RobotStudyCompanion/MechDesign/RSC_v4_1.step

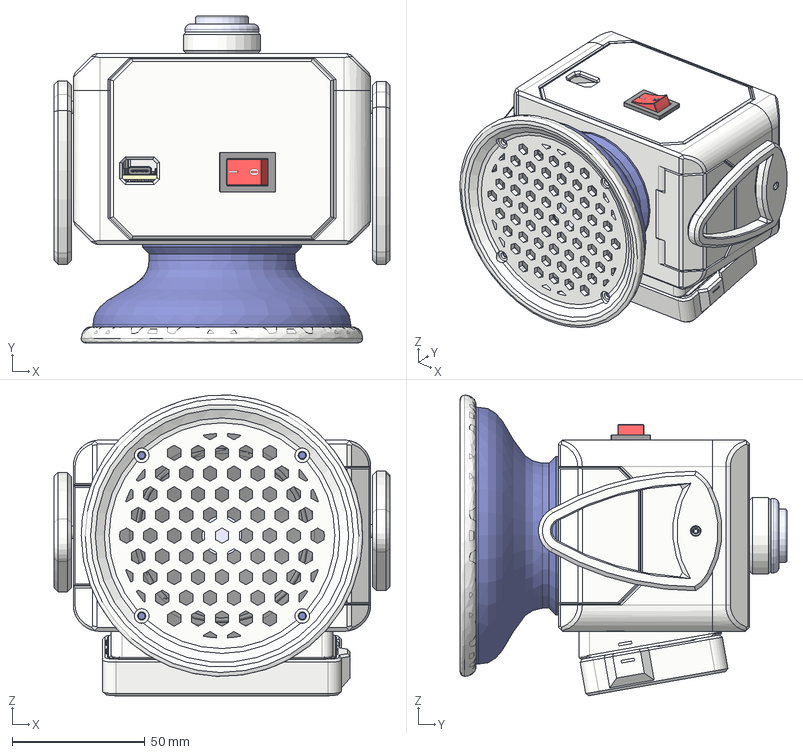
[picture p1: CAD file, 2026-01-30]
RSC_v4_1.step
126.5 x 123.0 x 113.2 mm
Sealing_Ring
Speaker_Trim
base_speaker
base2_speaker
PCB, RPi4ModelB
Broadcom BCM2711B0 CPU, RPi4ModelB
2.54 mm DUPONT MALE PIN HEADER, POE, 2X2, RPi4ModelB
2.54 mm DUPONT MALE PIN HEADER, IO, 2X20, RPi4ModelB
Camera Connector, RPi4ModelB
Microphone Plug, RPi4ModelB
Display Connector, RPi4ModelB
Gigabit Ethernet Port, RPi4ModelB
Female Micro HDMI Connector, RPi4ModelB x 2
Female USB Type C Connector, RPi4ModelB
2X USB3.0 PORTS, RPi4ModelB
91D77 D9WHV 778K, 4 GB LPDDR4 SDRAM, RPi4ModelB
Cypress CYW43455 Wireless Module Cover, RPi4ModelB
SD Card Slot, RPi4ModelB
VIA VL805 PCIe USB 3.0 controller, RPi4ModelB
2X USB2.0 PORTS, RPi4ModelB
Broadcom BCM54213PE Gigabit Ethernet Transceiver, RPi4ModelB
MxL7704 Universal PMIC, RPi4ModelB
VoiceBonnet
TactalSwitch-SMD
earphone
Motor base x 2
shaft x 2
top x 2
servo_shaft x 2
servo_horn x 2
SD_Latch
USB_Latch
flipper x 2
Arcade_PushButton
NeoPixelRing16
ButtonLock_Nut
Lambalı Anahtar - Gövde
Lambalı Anahtar - Tuş
Lambalı Anahtar - Tuş arkası
Panel_Adapter
10mm connector x 3
Spkr Connector
switch_1 x 2
Micro SD Card
ESP32 WROOM
Micro USB 5 Pins, Right Angle SMT v1
LDR 21
