RobotStudyCompanion/MechDesign/v4_1/print_project_a1m_RSC_v4_1_v256.3mf

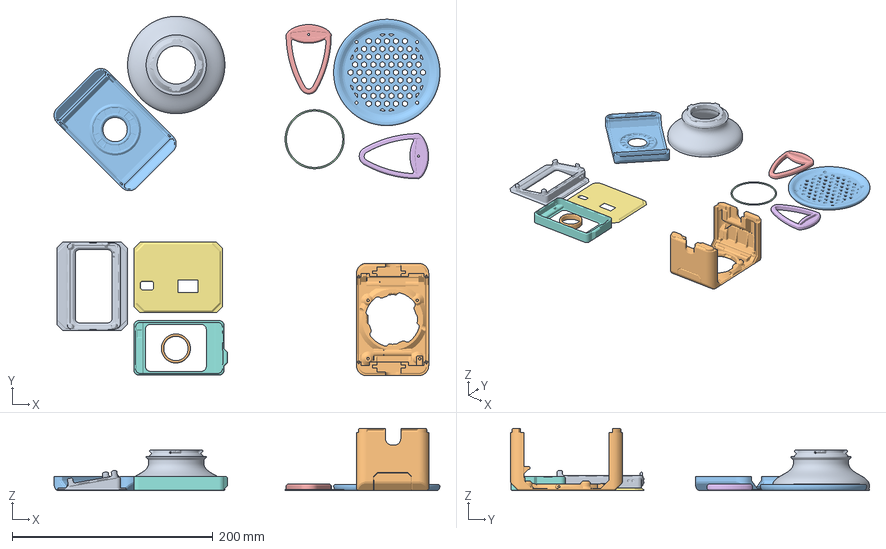
[picture p2: CAD file, 2026-01-30]
v4_1/print_project_a1m_RSC_v4_1_v256.3mf
384.7 x 358.1 x 62.0 mm
Speaker_Shroud
chassis_RSC_v4_1_v256
Base_Trim
Seal
flipper x 2
Back_Panel
LCD_Cover
Panel_Adapter
Spacer
Lid
