RobotStudyCompanion/MechDesign/v4_1/v4_1_2/TPU_flipper_RSC_v4_1_v282.3mf

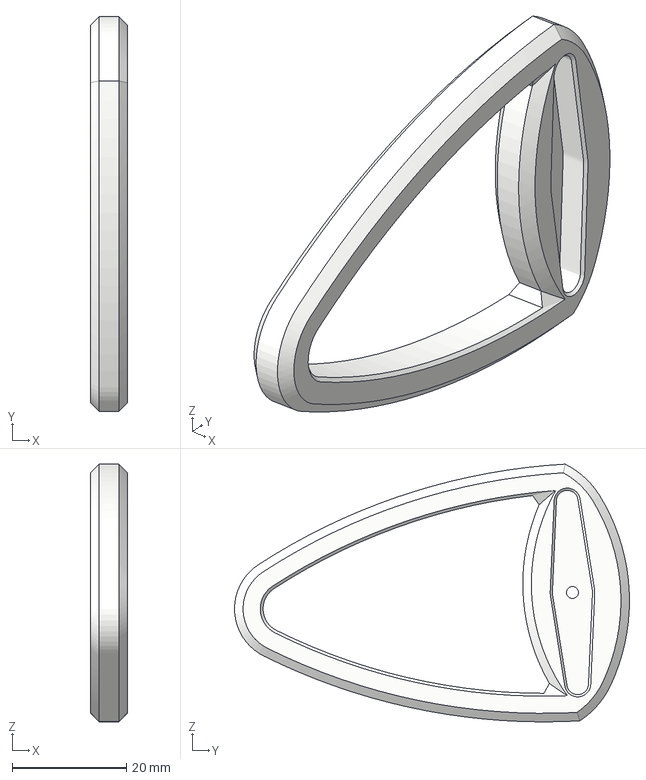
[picture p3: CAD file, 2026-08-03]
v4_1/v4_1_2/TPU_flipper_RSC_v4_1_v282.3mf
6.50 x 69.1 x 45.1 mm
