RobotStudyCompanion/MechDesign/RSCv4_base_lid_flipper.3mf

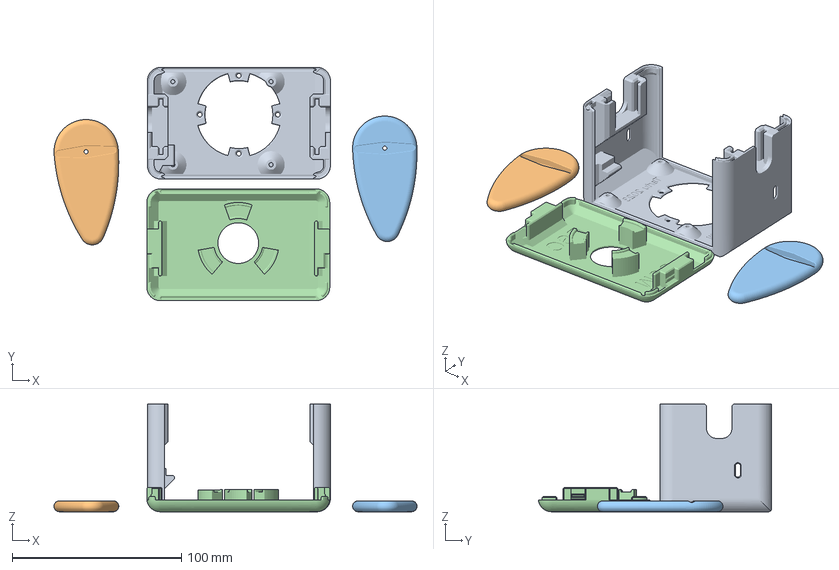
[picture p4: CAD file, 2023-09-24]
RSCv4_base_lid_flipper.3mf
214.2 x 137.8 x 63.5 mm
body_bracket
flipper x 2
lid_panel
