RobotStudyCompanion/MechDesign/v4_1/front_panel_RSC_v4_1_v267.3mf

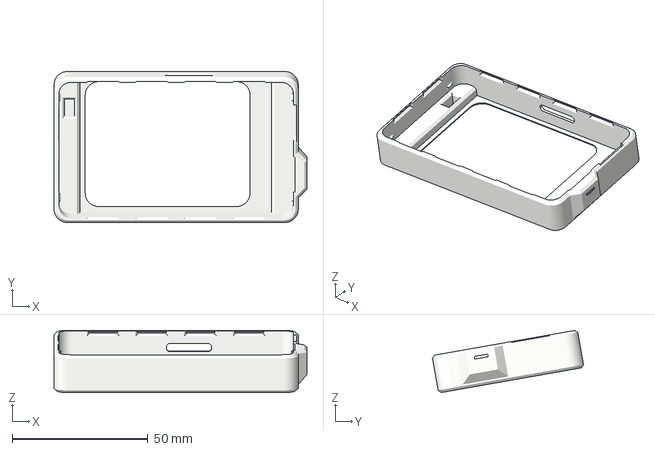
[picture p5: CAD file, 2026-01-30]
v4_1/front_panel_RSC_v4_1_v267.3mf
93.2 x 55.7 x 22.9 mm
