RobotStudyCompanion/MechDesign/RSCv4_speaker_shroud.3mf

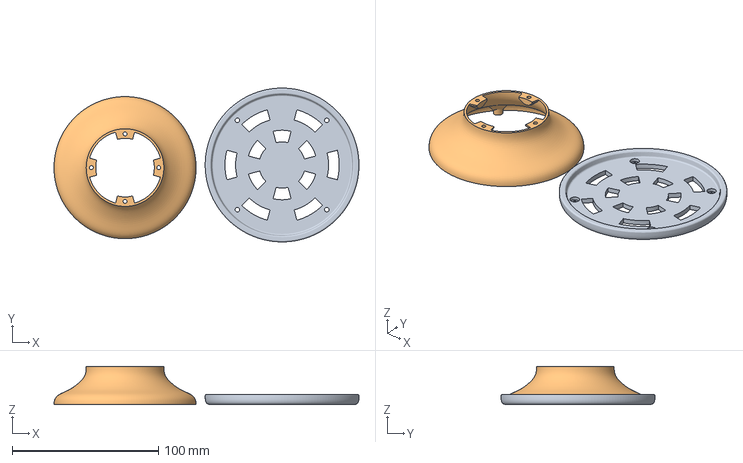
[picture p7: CAD file, 2023-09-24]
RSCv4_speaker_shroud.3mf
208.2 x 105.0 x 26.1 mm
speaker_base
speaker_shroud
