RobotStudyCompanion/MechDesign/v4_1/TPU_seal_ring_RSC_v4_1_v256.3mf

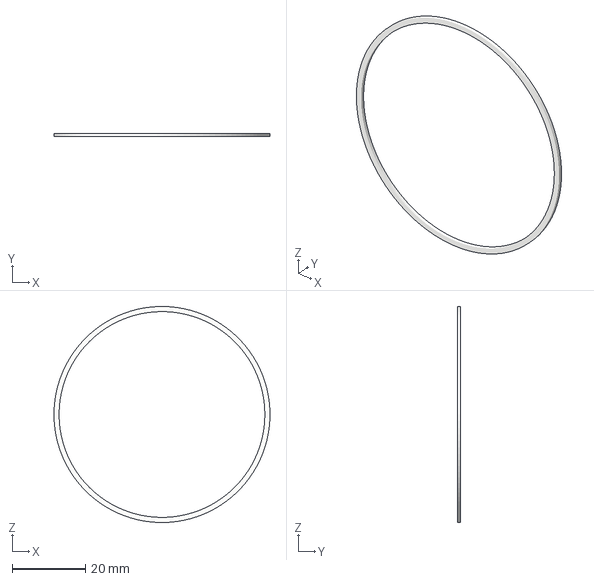
[picture p8: CAD file, 2026-01-30]
v4_1/TPU_seal_ring_RSC_v4_1_v256.3mf
58.9 x 0.9 x 58.9 mm
