RobotStudyCompanion/MechDesign/v4_1/v4_1_2/shroud_perforated_RSC_v4_1_v289.3mf

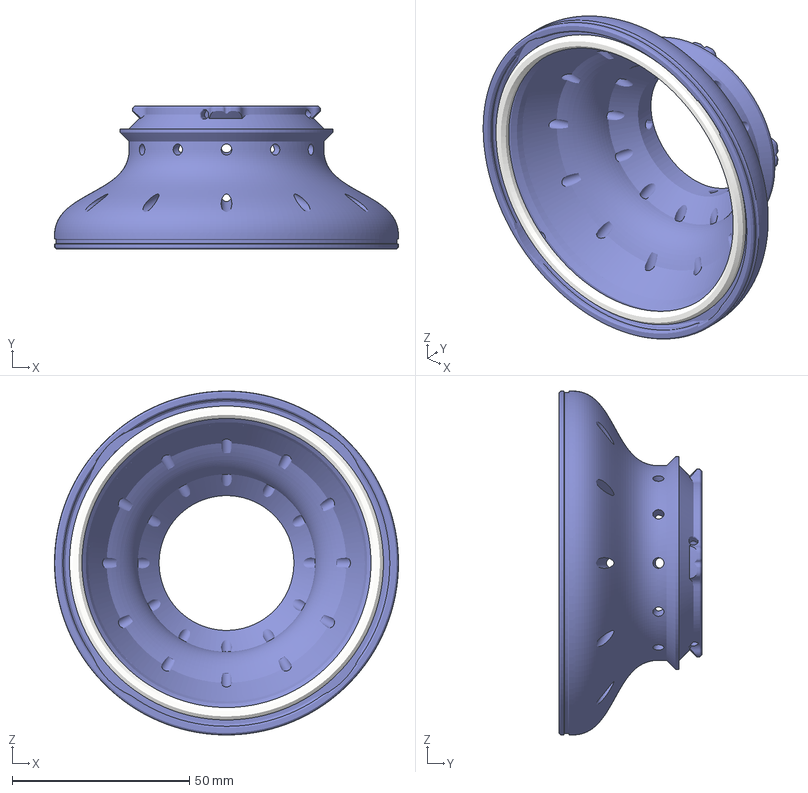
[picture p9: CAD file, 2026-08-03]
v4_1/v4_1_2/shroud_perforated_RSC_v4_1_v289.3mf
97.0 x 40.4 x 97.0 mm
Speaker_Shroud
ring_support
