RobotStudyCompanion/MechDesign/v4_1/v4_1_2/back_RSC_v4_1_v293.3mf

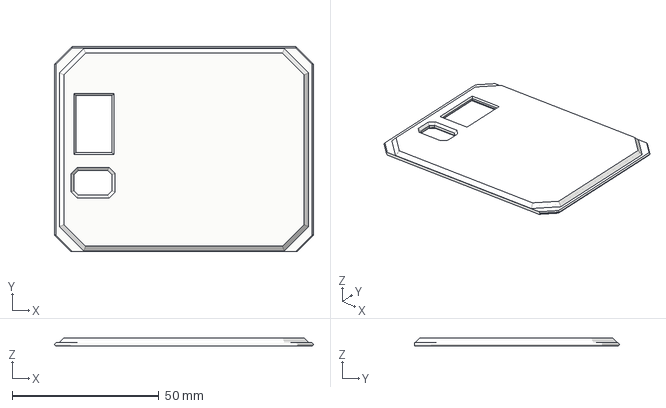
[picture p10: CAD file, 2026-08-03]
v4_1/v4_1_2/back_RSC_v4_1_v293.3mf
88.3 x 69.8 x 2.82 mm
