RobotStudyCompanion/MechDesign/v4_1/lid_spacer_RSC_v4_1_v256.3mf

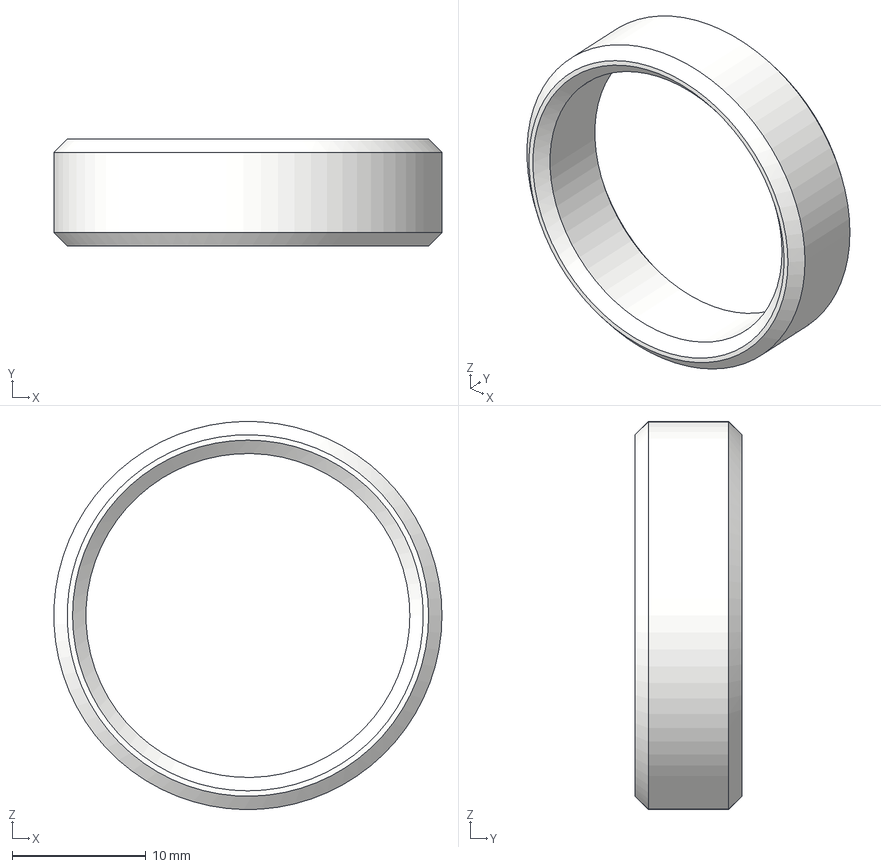
[picture p11: CAD file, 2026-01-30]
v4_1/lid_spacer_RSC_v4_1_v256.3mf
29.0 x 8.00 x 29.0 mm
