RobotStudyCompanion/MechDesign/v4_1/v4_1_2/RSC_KIT_v4_1_v282.3mf

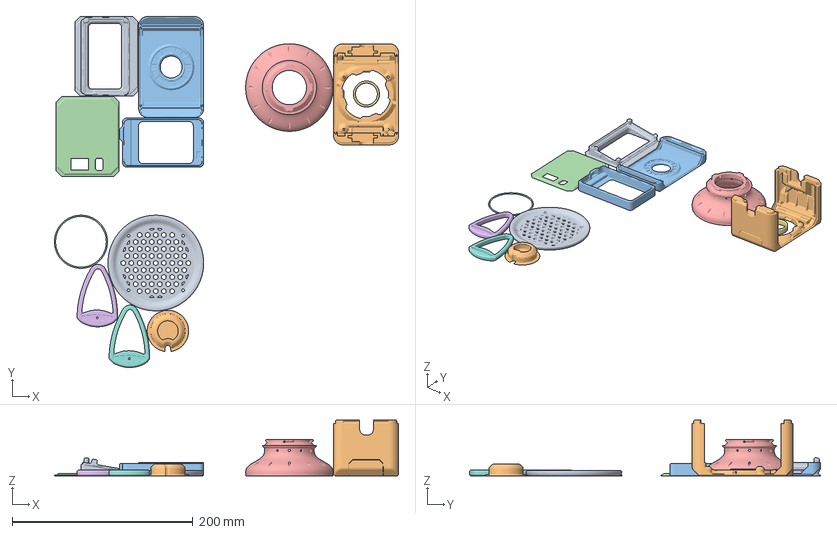
[picture p12: CAD file, 2026-08-03]
v4_1/v4_1_2/RSC_KIT_v4_1_v282.3mf
381.4 x 388.9 x 62.0 mm
Base_Trim
chassis_RSC_v4_1_v289
Lid
Seal
shroud_perforated_RSC_v4_1_v289
flipper x 2
Spacer
Panel_Adapter
speaker_plug
LCD_Cover
Back_Panel
