RobotStudyCompanion/MechDesign/v4_1/TPU_trim_RSC_v4_1_v256.3mf

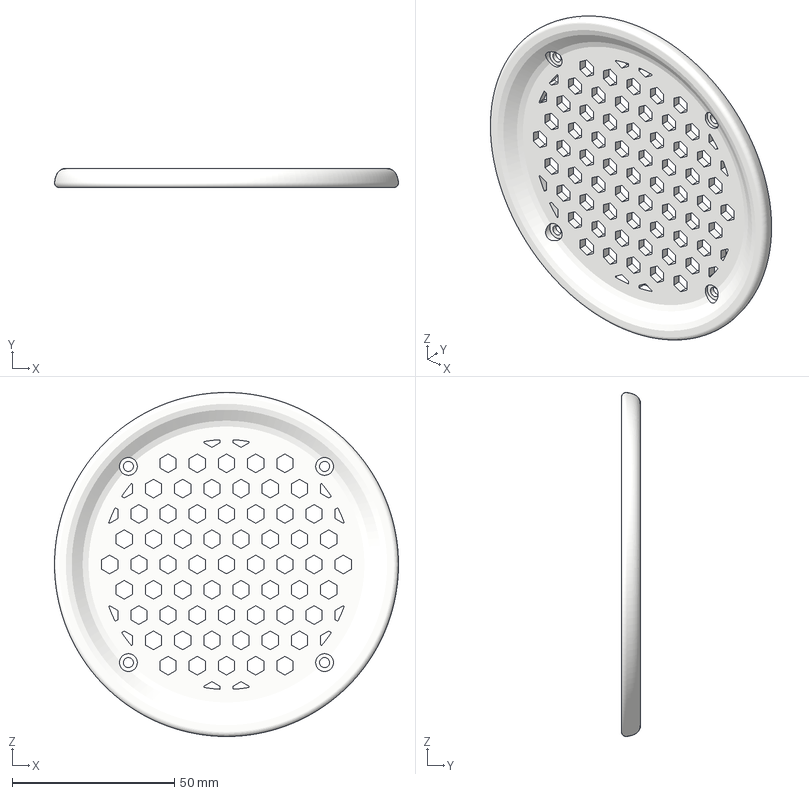
[picture p13: CAD file, 2026-01-30]
v4_1/TPU_trim_RSC_v4_1_v256.3mf
106.0 x 6.00 x 106.0 mm
