RobotStudyCompanion/MechDesign/v4_1/v4_1_2/lid_kit_RSC_v4_1_v290.3mf

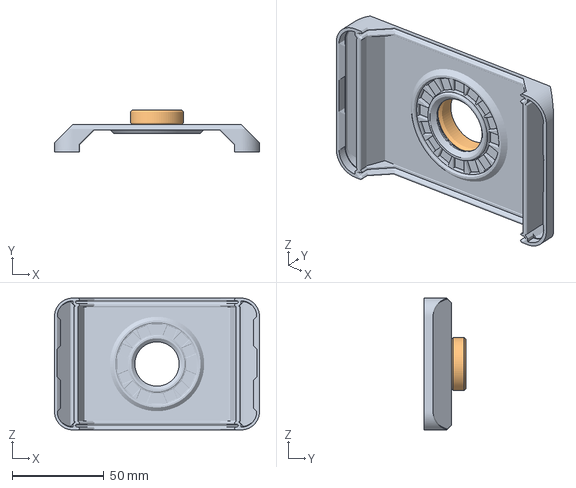
[picture p14: CAD file, 2026-08-03]
v4_1/v4_1_2/lid_kit_RSC_v4_1_v290.3mf
112.0 x 23.0 x 72.0 mm
Lid
Spacer
