RobotStudyCompanion/MechDesign/v4_1/shroud_RSC_v4_1_v256.3mf

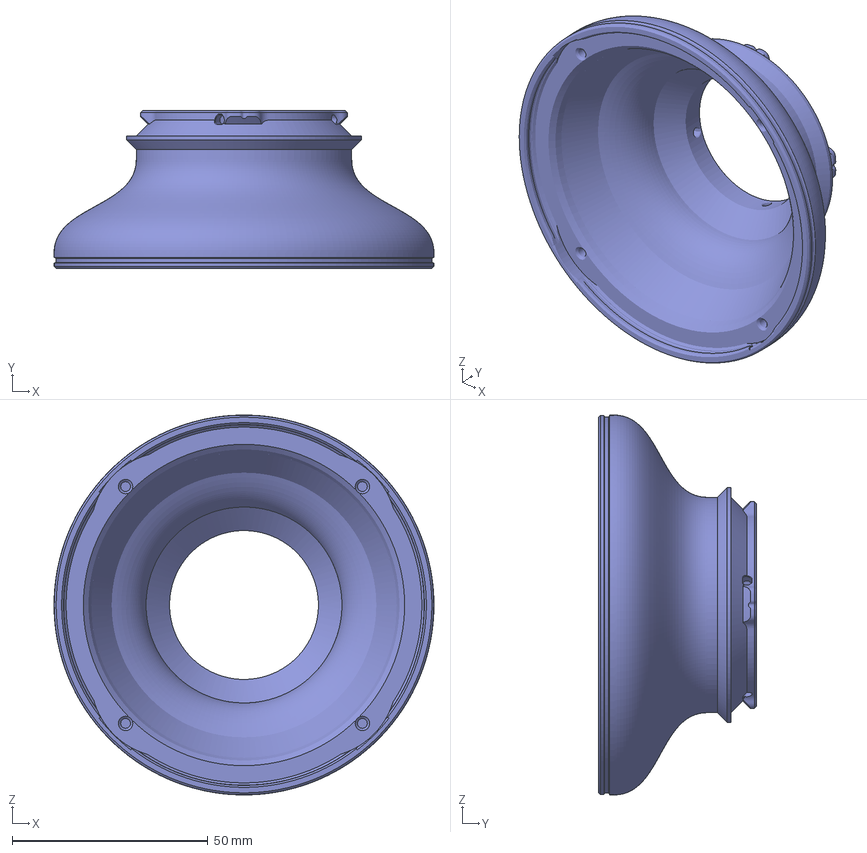
[picture p15: CAD file, 2026-01-30]
v4_1/shroud_RSC_v4_1_v256.3mf
97.0 x 40.4 x 97.0 mm
