RobotStudyCompanion/MechDesign/v4_1/LID_RSC_v4_1_v216.3mf

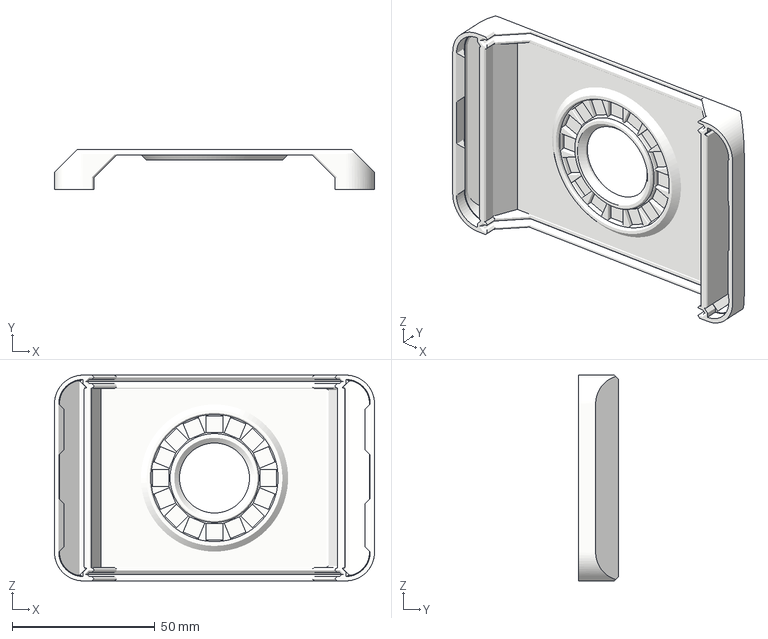
[picture p16: CAD file, 2025-05-25]
v4_1/LID_RSC_v4_1_v216.3mf
112.0 x 14.0 x 72.0 mm
