RobotStudyCompanion/MechDesign/v4_1/v4_1_2/speaker_plug_RSC_v4_1_v289.3mf

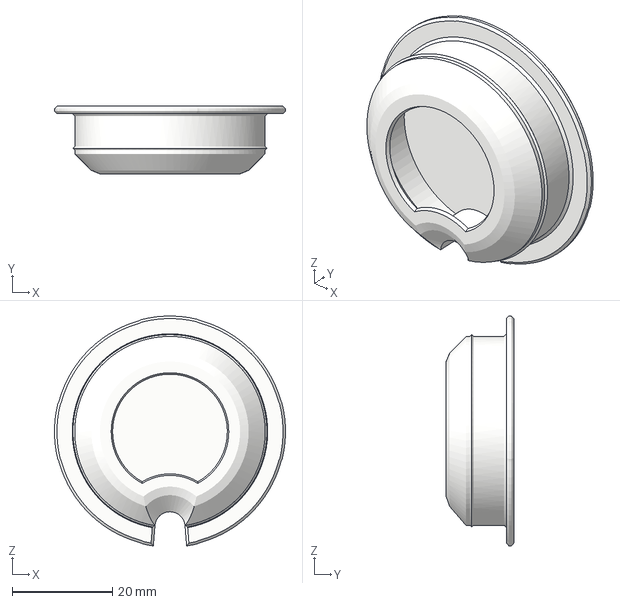
[picture p17: CAD file, 2026-08-03]
v4_1/v4_1_2/speaker_plug_RSC_v4_1_v289.3mf
46.0 x 13.5 x 45.8 mm
