RobotStudyCompanion/MechDesign/v4_1/FLIPPER_RSC_v4_1_v230.3mf

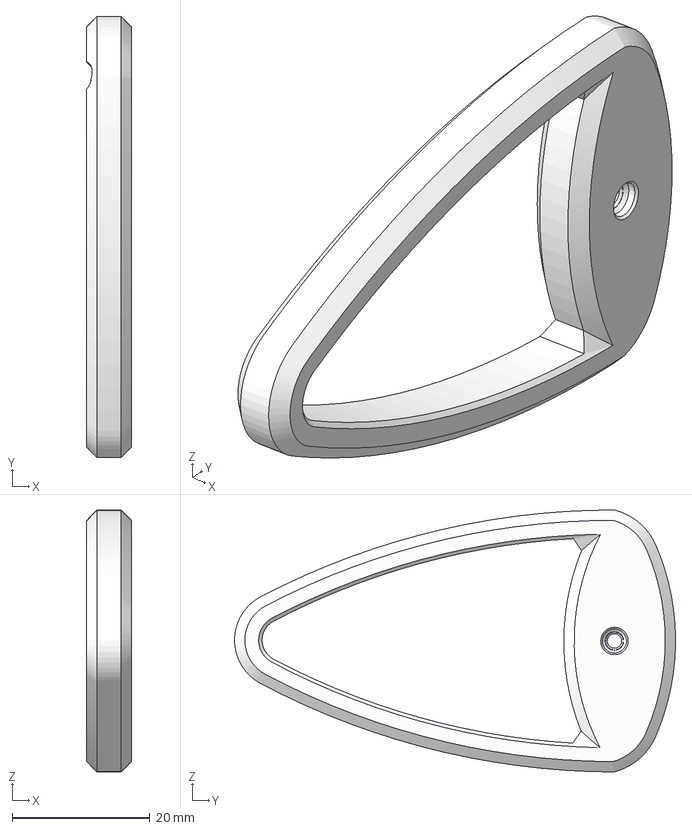
[picture p18: CAD file, 2025-05-25]
v4_1/FLIPPER_RSC_v4_1_v230.3mf
6.50 x 64.0 x 38.0 mm
