RobotStudyCompanion/MechDesign/v4_1/v4_1_2/chassis_RSC_v4_1_v289.3mf

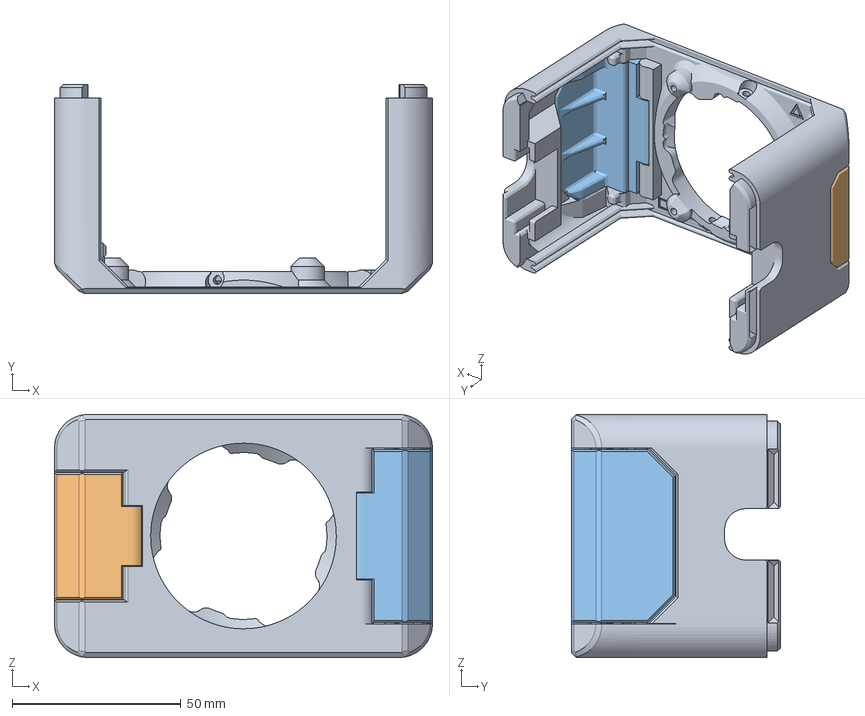
[picture p19: CAD file, 2026-08-03]
v4_1/v4_1_2/chassis_RSC_v4_1_v289.3mf
112.0 x 62.0 x 72.0 mm
Chassis
SD_Latch
USB_Latch
