RobotStudyCompanion/MechDesign/v4_1/v4_1_2/RSC_v4_1_1.step

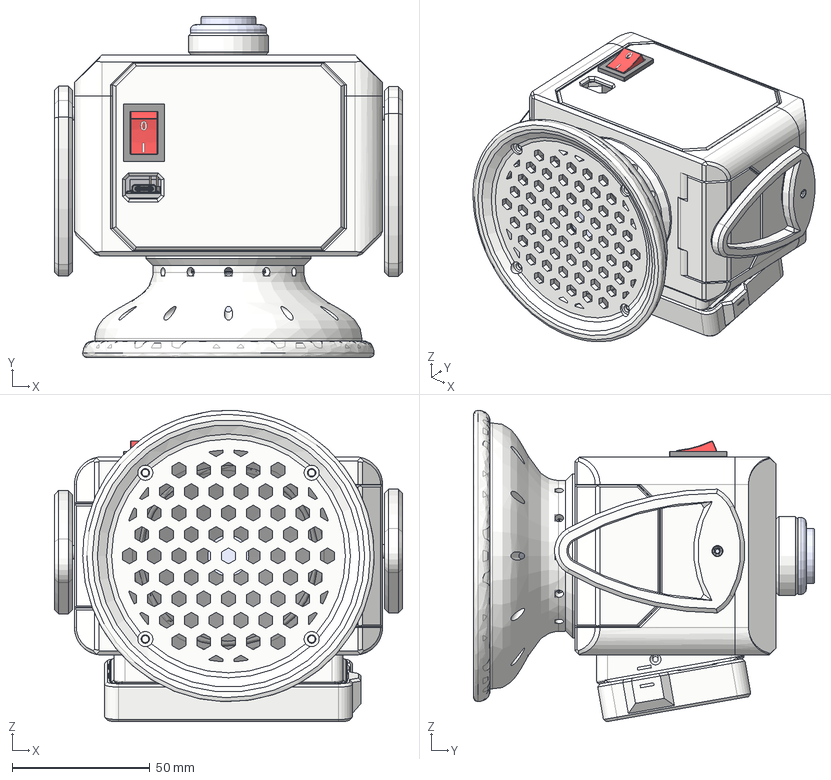
[picture p20: CAD file, 2026-08-03]
v4_1/v4_1_2/RSC_v4_1_1.step
126.5 x 124.0 x 113.2 mm
Sealing_Ring
Speaker_Trim
base_speaker
base2_speaker
PCB, RPi4ModelB
Broadcom BCM2711B0 CPU, RPi4ModelB
2.54 mm DUPONT MALE PIN HEADER, POE, 2X2, RPi4ModelB
2.54 mm DUPONT MALE PIN HEADER, IO, 2X20, RPi4ModelB
Camera Connector, RPi4ModelB
Microphone Plug, RPi4ModelB
Display Connector, RPi4ModelB
Gigabit Ethernet Port, RPi4ModelB
Female Micro HDMI Connector, RPi4ModelB x 2
Female USB Type C Connector, RPi4ModelB
2X USB3.0 PORTS, RPi4ModelB
91D77 D9WHV 778K, 4 GB LPDDR4 SDRAM, RPi4ModelB
Cypress CYW43455 Wireless Module Cover, RPi4ModelB
SD Card Slot, RPi4ModelB
VIA VL805 PCIe USB 3.0 controller, RPi4ModelB
2X USB2.0 PORTS, RPi4ModelB
Broadcom BCM54213PE Gigabit Ethernet Transceiver, RPi4ModelB
MxL7704 Universal PMIC, RPi4ModelB
Motor base x 2
shaft x 2
top x 2
servo_shaft x 2
servo_horn x 2
SD_Latch
USB_Latch
flipper x 2
C_0603_1608Metric x 22
R_0603_1608Metric x 34
PinSocket_1x10_P2.54mm_Vertical
C_0805_2012Metric x 6
PinHeader_1x03_P2.54mm_Vertical x 6
QFN-24-1EP_4x4mm_P0.5mm_EP2.6x2.6mm
SOT-23
PinHeader_1x02_P2.54mm_Vertical x 3
Diodes_PowerDI3333-8 x 2
PinHeader_1x04_P2.54mm_Vertical
USB_C_Receptacle_GCT_USB4125-xx-x-0190_6P_TopMnt_Horizontal
RSC_extension_board_silkscreen
RSC_extension_board_soldermask
RSC_extension_board_PCB
/var/mobile/Containers/Data/Application/ED4C2A4C-7E5D-45B7-BA36-C0186 4C68EB8/Documents/A2867DB8-CD23-456E-BED2-81E4105DE953.tmp
Arcade_PushButton.f3d
NeoPixelRing16.f3d
ButtonLock_Nut.f3d
Lambalı Anahtar - Gövde
Lambalı Anahtar - Tuş
Lambalı Anahtar - Tuş arkası
Panel_Adapter
10mm connector x 3
Spkr Connector
switch_1 x 2
Micro SD Card
ESP32 WROOM
Micro USB 5 Pins, Right Angle SMT v1
LDR 21
