RobotStudyCompanion/MechDesign/v4_1/v4_1_2/front_panel_kit_RSC_v4_1_v282.3mf

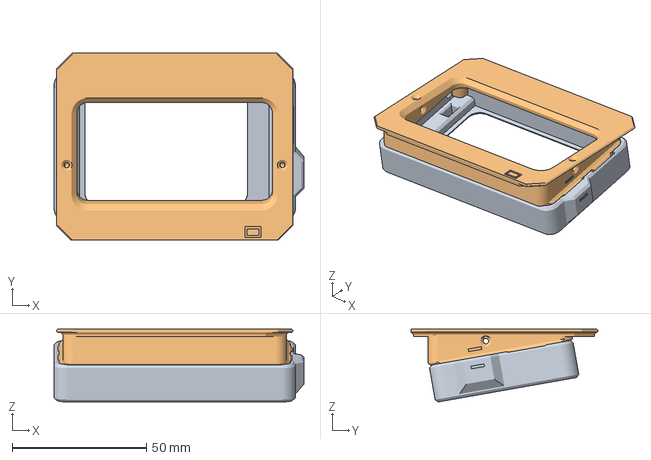
[picture p21: CAD file, 2026-08-03]
v4_1/v4_1_2/front_panel_kit_RSC_v4_1_v282.3mf
93.2 x 69.8 x 27.2 mm
LCD_Cover
Panel_Adapter
