RobotStudyCompanion/MechDesign/(list of files, cad)

Other CAD files:
v4_1/sliced/PANELS_spacer_A1M_RSC_v4_1_v228.gcode.3mf
v4_1/TPU_flipper_RSC_v4_1_v256.3mf
v4_1/v4_1_2/lid_kit_RSC_v4_1_v282.3mf
v4_1/SHROUD_RSC_v4_1_v227.3mf
v4_1/v4_1_2/back_RSC_v4_1_v282.3mf
v4_1/v4_1_2/seal_RSC_v4_1_v282.3mf
v4_1/v4_1_2/TPU_trim_RSC_v4_1_v282.3mf
v4_1/v4_1_2/chassis_RSC_v4_1_v282.3mf
RSC_v4_1.f3z
v4/RSCv4_assembly v68.f3z
v4/RSCv4_assembly v68.step
v4/RSCv4_front_back.3mf
v4/base.3mf
v4/base_lid.3mf
v4/lid.3mf
v4/shroud.3mf
v4/trim.3mf
v4_1/deprecated/BACK_Panel_RSC_v4_1_v227.3mf
v4_1/deprecated/CHASSIS_RSC_v4_1_v227.3mf
v4_1/deprecated/FRONT_PANEL_RSC_v4_1_v228.3mf
v4_1/deprecated/SEAL_RSC_v4_1_v230.3mf
v4_1/deprecated/SPACER_RSC_v4_1_v231.3mf
v4_1/deprecated/TRIM_RSC_v4_1_v230.3mf
v4_1/sliced/archive/17g_flipper_v11_1_5hrs.gcode.3mf
v4_1/sliced/archive/23g_TPU_LID_RSC_v4_1_v141_2hrs.gcode.3mf
v4_1/sliced/archive/23g_TRIM_RSC_v4_1_v90_TPU_2hrs.gcode.3mf
v4_1/sliced/archive/23g_v4_trim_TPU_2hrs.gcode.3mf
v4_1/sliced/archive/24g_Seal_Base_Trim_RSC_v4_1_v111.gcode.3mf
v4_1/sliced/archive/24g_TRIM_SEAL_RSC_v4_1_v120_TPU.gcode.3mf
v4_1/sliced/archive/24g_TRIM_SEAL_RSC_v4_1_v121_TPU_A1M.gcode.3mf
v4_1/sliced/archive/33g_Flipper_Seal_Trim_TPU_2hrs_47m.gcode.3mf
v4_1/sliced/archive/33g_TRIM_FLIPPER_SEAL_KIT_TPU_RSC_v4_1_v143_3hrs.gcode.3mf
v4_1/sliced/archive/38g_Flipper_Seal_Trim_TPU_3hrs.gcode.3mf
v4_1/sliced/archive/38g_v4_trim_flipper_3hrs.gcode.3mf
v4_1/sliced/archive/FLIPPER_4x_RSC_v4_1_v164.gcode.3mf
v4_1/sliced/archive/LID_A1M_PLA_RSC_v4_1_v216.gcode.3mf
v4_1/sliced/archive/SHROUD_CHASSIS_A1M_3hrs_RSC_v4_1_v227.gcode.3mf
v4_1/sliced/archive/TRIM_FLIPPERs_SEAL_A1M_TPU_RSC_v4_1_v230.gcode.3mf
v4_1/sliced/archive/tightCHASSIS_RSC_v4_1_v169.gcode.3mf
v4_1/v4_1_1/back_RSC_v4_1_v256.3mf
v4_1/v4_1_1/chassis_RSC_v4_1_v258.3mf
v4_1/v4_1_1/front_kit_RSC_v4_1_v260.3mf
v4_1/v4_1_1/lid_RSC_v4_1_v258.3mf
v4_1/v4_1_2/RSC_v4_1_1.f3z
