RobotStudyCompanion/MechDesign/v4/RSC assembly (v4) Drawing v3.pdf

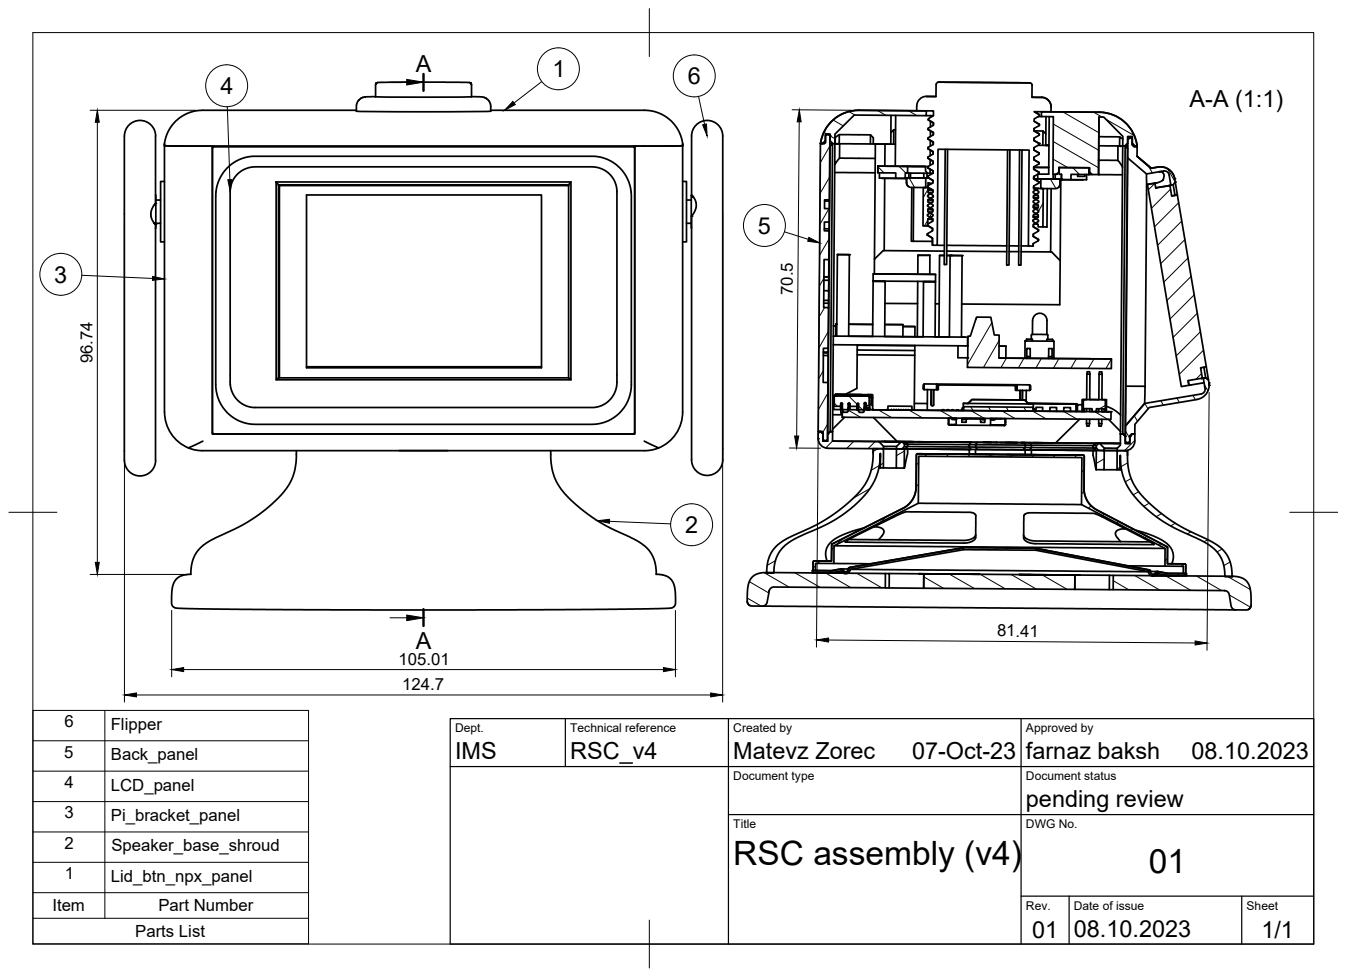
[picture p22: page 1]
Rev.; Date of issue; Sheet; Parts List; Item; Part Number

6 | Flipper
5 | Back_panel
4 | LCD_panel
3 | Pi_bracket_panel
2 | Speaker_base_shroud
1 | Lid_btn_npx_panel

Dept. IMS | Technical reference RSC_v4 | Created by Matevz Zorec 07-Oct-23 | Approved by farnaz baksh 08.10.2023

Document type | Document status pending review

Title RSC assembly (v4) | DWG No. 01
