RobotStudyCompanion/MechDesign/(commit log)

2023-09-24 RSCv4 CAD files
    [RSCv4_base_lid_flipper.3mf, RSCv4_front_back.3mf, RSCv4_speaker_shroud.3mf]
2025-05-25 add v4_1, add keychain files, add pcb, organised directories
2026-01-30 latest iter v4_1 RSC print files
2026-08-03 v4_1_2 - torxHAT support patch - reinforced parts, optimised chassis; updated exports
