RobotStudyCompanion/MechDesign/(notices)

Notices in the files:
README.md:
License: CERN-OHL-S
